sel00000/arduino-recycling-sorter/docs/code-review.ko.md

[English](code-review.md) | [한국어](code-review.ko.md)

# 코드 리뷰 — 기술 분석과 개선 제안

대회 당시 코드(`firmware/original/`)를 사후 분석한 문서입니다. `firmware/revised/`에
반영한 수정과, 코드에는 반영하지 않고 제안으로만 남긴 개선을 구분해 정리합니다.

## 스케치별 분석

### 1단계 — stage1_conveyor

**동작**: 초음파 2개로 거리를 측정해, 둘 다 기준(10cm/20cm) 이내로 물체가 감지되면
서보 0(벨트 구동), 하나라도 기준 밖이면 서보 90(연속회전 서보 기준 정지).

| # | 문제 | 처리 |
|---|---|---|
| 1 | `pulseIn(echo, HIGH)`에 타임아웃이 없어 에코 유실 시 기본 1초씩 통째로 대기. 센서가 2개 연쇄라 한 사이클이 2초 이상 멈출 수 있음 — "모터가 반응이 없다"고 느끼게 한 유력 원인 | revised: 30ms 타임아웃 + 실패 시 벨트 상태 유지 |
| 2 | 단발 측정이라 노이즈에 그대로 노출. 튄 값 한 번에 벨트가 들썩일 수 있음 | 제안: 3회 측정 중앙값 필터 |
| 3 | 연속회전 서보는 개체마다 정지점이 90에서 약간 어긋나 `write(90)`에도 벨트가 천천히 기는 경우가 있음 | 제안: `writeMicroseconds()`로 정지 펄스 폭 트림 |
| 4 | `int pos = 0;` 미사용 변수 | revised: 제거 |

### 2단계 — stage2_metal_sorter (초안)

**컴파일 오류 3건 (복합 원인 포함)** — 이 초안이 컴파일되지 않는 이유:

| 위치 | 코드 | 문제 |
|---|---|---|
| `setup()` | `pinMode(senor_pin, INPUT)` | `senor_pin` 미선언 (`#define senor 4`만 존재) |
| `setup()` | `tap_servo.attach(tap_servo_pin)` | `tap_servo`는 `#define tap_servo 5` 핀 매크로라 `.attach()` 호출 불가, `tap_servo_pin`도 미선언 |
| `loop()` | `digitalRead(sensor)` | `sensor` 미선언 (`senor`의 오타) |

같은 대상을 `senor`/`sensor`/`senor_pin`/`tap_servo`/`tap_servo_pin` 다섯 이름으로
부른 것이 원인입니다. revised에서는 핀을 `SENSOR_PIN`/`TAP_SERVO_PIN` 상수로
통일하고 서보를 `doorServo`/`tapServo` 객체로 분리했습니다.

**로직 측면**:
1. 측정 실패(에코 유실) 시 `duration=0 → distance=0 < 10`이라 **문이 열린 상태로
   고정**됩니다. 실패 모드가 "개방"인 것은 안전하지 않습니다. → revised: 타임아웃
   시 닫힘 유지
2. `if (val==0) {...} if (val==1) {...}`는 결과적으로 if/else와 같지만 의도가
   드러나지 않습니다. → revised: if/else로 명확화
3. 정전용량 근접센서는 출력 방식(NPN: 감지 시 LOW / PNP: 감지 시 HIGH)에 따라
   `val==0`의 의미가 뒤집히고, 24V 산업용 센서는 분압·레벨 변환이 필요합니다.
   사용한 모듈 기준의 배선 문서화가 함께 남았어야 했습니다.

### 3단계 — stage3_weight_sorter

**기록 상태**: 원문이 `loop()` 내부에서 끊겨 닫는 중괄호가 유실 → revised에서 복원.

참고: 3단계의 Serial 속도는 38400으로 1·2단계(115200)와 다릅니다. 보드별 Serial
모니터 설정 시 유의하세요.

| # | 문제 | 처리 |
|---|---|---|
| 1 | `scale.get_units(5)`는 HX711 기본 10SPS 기준 약 0.5초 블로킹. 무거운 물체 경로는 delay 5회와 합쳐 사이클이 약 5.6초 — 처리량의 직접적 상한 | 제안: 표본 수 축소 또는 80SPS 모드, 상태기계화 |
| 2 | 연쇄 `delay(1000)`은 서보 떨림을 가리기 위한 완충(작성자 기록). 근본 원인은 전원일 가능성이 높음 — MG996R급은 스톨 시 약 2.5A까지 끌어갈 수 있는데 우노 5V 레귤레이터로는 부족 | 제안: 외부 5~6V 전원 + 공통 GND + 470~1000µF 커패시터 |
| 3 | 계수 23600이 기준 분동 없이 설정되어 측정 단위가 불명확 (심사 Q7) | 제안: ① 빈 저울 `tare()` ② 기준 분동(예: 1.000kg) 올림 ③ `get_units()`가 1.000이 될 때까지 계수 조정 |
| 4 | 측정값 0.5 이하는 어떤 분기에도 안 걸려 **배출되지 않음**. 빈 페트병(수십 g)이 주 대상임을 감안하면 캘리브레이션 부재와 결합해 임계값 실효성이 검증되지 않음 | revised: 동작은 원본 유지, 주석으로 한계 명시 |

## 아키텍처 분석

우노 3대가 **통신 없이 독립 동작**합니다. 단계 간 동기화 수단이 없어 물체가 이전
단계 처리 중에 도착하면 충돌하며, 이를 각 단계의 긴 delay로 회피했습니다. 작동은
했지만 처리량과 신뢰성을 모두 희생한 트레이드오프입니다.

## 개선 로드맵 (우선순위순)

1. **delay 제거 — `millis()` 상태기계**: 각 스케치를 대기/측정/동작 상태로
   재구성하면 센서 폴링과 서보 동작이 겹칠 수 있어 반응성이 살아납니다.
2. **서보 전원 분리**: 위 3단계 문제 2 항목. 떨림 완충용 delay를 걷어낼 수 있는
   전제 조건입니다.
3. **보드 간 핸드셰이크**: 디지털 핀 1개를 busy 신호로 공유하기만 해도 단계 충돌이
   사라집니다. 더 나아가면 우노 3대를 Mega 1대로 통합하거나 I2C
   마스터-슬레이브로 묶을 수 있습니다.
4. **종이 분류 — 저비용 비전**: ESP32-CAM(1만 원대)에 TensorFlow Lite Micro 또는
   Edge Impulse로 학습한 경량 CNN을 올리면 분광 센서 없이 종이/페트 구분이
   가능합니다. 당시 "이미지 센서로 구분은 되는데 모터 연동이 안 됐다"는 문제는
   분류 보드와 구동 보드를 분리하고 시리얼로 분류 결과만 넘기는 구조로 풀 수
   있습니다.
5. **형상 정규화**: 투입 직후 압축 기구(산업 선별장의 압축 공정과 같은 원리)로
   형상 불균일 문제를 구조적으로 해결합니다.
