sel00000/arduino-recycling-sorter/docs/references.ko.md

[English](references.md) | [한국어](references.ko.md)

# 참고 자료 모음

프로젝트 진행 중 조사한 자료의 원본 목록입니다. 당시 기록 그대로 옮겼으며, 링크
생존 여부는 보장하지 않습니다.

## 센서

### 이미지 센서
- 아두이노에서 이미지 센서를 이용한 색상 트래킹 팬틸트 구현 (PinkWink) — https://pinkwink.kr/1150

### 주파수(사운드) 센서
- 아두이노와 사운드 센서를 이용한 주파수 변환(FFT) — https://youtube.com/shorts/Ipk9SH9DfGQ?feature=share

### 소리감지 센서
- 아두이노 코딩 #11 소리감지센서 (공대선배) — https://youtu.be/N6v8owKJz8M

### 초음파 센서
- 아두이노 다중 초음파센서 사용 (친절한삐삐씨) — https://m.blog.naver.com/vitro6273/221200479936

### 인체 감지 센서
- 인체 감지센서로 침입자 경보 부저 만들기 (ICbanQ) — https://blog.naver.com/icbanq/222735710606

### 무게 감지 센서 (로드셀)
- 로드셀 무게감지 센서로 무게 측정하기 (로보다인시스템) — https://m.blog.naver.com/eduino/221078931222

### 정전용량 센서
- [디스플레이 톺아보기] TSP(터치스크린패널)의 종류와 원리 (삼성디스플레이 뉴스룸) — https://news.samsungdisplay.com/12710
- 정전용량 터치센서의 원리 (tonykwun) — https://m.blog.naver.com/tonykwun/120175645334
- 정전용량 센서 원리 (안쓰리김원) — https://m.blog.naver.com/ysahn2k/220147025746
- 정전 용량식 레벨계 측정 원리 (Endress+Hauser) — https://youtu.be/n5pGu-LuJXY
- 정전용량 터치센서란? 센서 구현하기 (오픈랩) — https://m.blog.naver.com/roboholic84/221372823607
- 축전기 (위키백과) — https://ko.wikipedia.org/wiki/축전기
- 정전용량형 근접센서와 음료수 캔으로 악기 만들기 (러봇랩) — https://youtu.be/ZjHH4AZI19s

### 근접센서 일반
- 근접센서(Proximity sensors) (Technicus) — https://blog.naver.com/technicus81/222855634213
- 정전 용량형 센서란? — https://avtotachki.com/ko/chto-takoe-emkostnyj-datchik/
- Testing a capacitive proximity sensor (Curious Scientist) — https://youtu.be/F0YeykVvEQ4
- Inductive vs. capacitive sensors (SENSOR PARTNERS) — https://www.sensorpartners.com/en/knowledge-base/the-difference-between-inductive-and-capacitive-sensors/
- 아두이노 유도형 근접 센서 사용하기 (Miracle) — https://m.blog.naver.com/PostView.naver?isHttpsRedirect=true&blogId=123gtf&logNo=221233489523
- Tech Tip: Inductive vs Capacitive Sensors (Ramco) — https://www.ramcoi.com/blog/220/tech-tip-inductive-vs-capacitive-sensors
- 정전용량식 근접센서의 원리 — https://article2.tistory.com/824
- 그림으로 이해하는 근접 센서 기초 (픽써엘) — https://youtu.be/-b_IYP74aPs
- 근접센서 PNP DC24V 원리 이해 (볼트메이커) — https://youtu.be/jbym2VNjBPM
- CR18-8DP/8DN/8AO 정전용량 센서의 모든 것 (장갑낀 맥가이버) — https://youtu.be/0xn9uTSGfj0
- 근접 센서 (센서로세계로미래로) — https://m.blog.naver.com/iotsensor/221469817024
- 점유·이동·근접 센서 (KOCW 충남대 강의자료) — http://contents.kocw.or.kr/KOCW/document/2016/chungnam/chahanju/9.pdf
- 자동화센서 11.4~11.7 (bbkim전자) — https://youtu.be/zAZ2H2QhHYM
- 근접 센서 (위키백과) — https://ko.wikipedia.org/wiki/근접_센서

### 유도형 근접센서
- 금속탐지기 작동 원리 (미국아재 교실) — https://www.youtube.com/watch?v=RMSqL3DOiO8
- 유도형(고주파 발진형) 근접 센서 설명 (픽써엘) — https://youtu.be/V86LwSNa1FE
- 와전류가 발생하는 구조 (임장성) — https://m.blog.naver.com/jsrhim516/221143080811
- 와전류 손실(철손)이란? (젠지노 창고) — https://yyxx.tistory.com/127

## 구조
- 자판기가 작동하는 원리/내부구조 — https://youtu.be/j3927pdgcTM
- AI 기반 똑똑한 분리수거기 (AI타임스) — https://youtu.be/8M4FtqOvVXQ
- 못쓰는 가전제품 배출 및 처리 과정 — https://youtu.be/CokoCupngyI
- 재활용쓰레기 분류 AI 로봇 (ITmoda) — https://youtu.be/6yUbOwQcC6w
- 재활용 선별장 첨단화 — 플라스틱 재질까지 구별 (뉴스트리) — https://youtu.be/AD_57RcEiIY
- 재활용품 분류의 달인 (SBS 생활의 달인 559회) — https://youtu.be/iv1eyqVMFCM
- 분리수거 자동화 시스템 Recyclear 분류 영상 — https://youtu.be/IsF19la8Tis
- 과학상자에서 리미트 스위치를 이용한 모터 동작 범위 제어 — https://youtu.be/OOMzq58qVvc

### 컨베이어 구조
- 과학상자로 탱크 만들기 — https://youtu.be/Qe5bKgvNuy4
- How To Make Stickers (Mahalo my Dude) — https://youtu.be/GlecDUdZdkE
- Can Lego Play the Drums? (Brick Technology) — https://youtu.be/BlaY8kSTO28
- Conveyor belt toy (MrMickPosner) — https://youtu.be/2aVdOXWo-2Q
- Low Cost Automatic Multi-Purpose Mini Conveyor Belt (Miheer Maniar) — https://youtu.be/udW1BXp7NXw
- How to Make a Conveyor Belt System at Home (Easy HomeMade Projects) — https://youtu.be/o7VVmtX7SKs
- How to Build a Belt Conveyor (C-Trak Conveyors) — https://youtu.be/TET4ksZ1b2g

## 납땜·배선
- Arduino Bluetooth control car (L293D, HC-05) (Make DIY) — https://youtu.be/hI0UBvpuRTw

## 모터 (서보)
- 서보모터 구성, 서보드라이브가 분리된 이유 (공장자동화TV) — https://youtu.be/CQgS90fcY10
- Arduino Servo Motor MG996R (올마코딩) — https://youtu.be/EXRFdmsEK8k
- 왜 서보 모터가 움직이지 않을까? L293D 모터쉴드 (H_World) — https://youtu.be/VoQCWI9ojsc
- Servo Motors, how do they work? (The Engineering Mindset) — https://youtu.be/1WnGv-DPexc
- Servo Motor with Arduino MG996 (SDev Electronics) — https://youtu.be/WPQNad2gvEs
- 서보모터 떨림 현상 원인 — 전류 부족/GND 미연결 (for Makers) — https://youtu.be/qywuAx00x2k
- Servo motors vibration problem: solution with capacitor (Global Spy Hawk) — https://youtu.be/zasQSK4CulE
- 서보모터가 이상하게 작동해요 (아토플래닛) — https://m.blog.naver.com/dokkosam/221387857799
- Servo MG996R, Arduino Uno (Noc A) — https://youtu.be/wszxVSf1d1w

## 시간 처리 (delay/millis)
- 시간 관련 함수 설명, delay 없이 LED Blink (juahnpop) — https://juahnpop.tistory.com/75
- 시간 관련 함수 delay()/millis() — https://blog.naver.com/yuyyulee/220315430768

## 코딩 일반
- 코딩스탠다드: 함수 작성 (포프TV) — https://youtu.be/rbWSTXBYNFA
