sel00000/arduino-recycling-sorter/firmware/original/stage1_conveyor/stage1_conveyor.ino

/*
 * [Original record] Stage 1 conveyor belt — code as submitted to the Nano Day
 * competition, preserved unmodified (it compiles). The Korean comments below are
 * part of the historical record. Cleaned-up version: firmware/revised/stage1_conveyor/
 */
#include <Servo.h>
Servo servo1;

int echo1=3,trig1=2;
int echo2=5,trig2=4;

int pos=0;

void setup(){
  pinMode(trig1,OUTPUT);
  pinMode(echo1,INPUT);

  pinMode(trig2,OUTPUT);
  pinMode(echo2,INPUT);

  servo1.attach(9);
  Serial.begin(115200);
}

void loop(){
  delay(100);
  digitalWrite(trig1,HIGH);
  delayMicroseconds(10);
  digitalWrite(trig1,LOW);

  long distance1=pulseIn(echo1,HIGH)/58.2;

  Serial.print("distance1");
  Serial.print(distance1);
  Serial.println("cm");

  delay(100);
  digitalWrite(trig2,HIGH);
  delayMicroseconds(10);
  digitalWrite(trig2,LOW);

  long distance2=pulseIn(echo2,HIGH)/58.2;

  Serial.print("distance2");
  Serial.print(distance2);
  Serial.println("cm");

  if((distance1>10)||(distance2>20)){
    delay(50);
    servo1.write(90);
    delay(50);
      }else {
        servo1.write(0);
  }
}
