sel00000/arduino-recycling-sorter/(commit log)

2026-06-13 chore: 저장소 초기화 — .gitignore, 시제품 사진
2026-06-13 docs(firmware): 대회 당시 원본 스케치 3종 보존
    stage2는 초안(컴파일 불가), stage3은 기록 유실로 끝부분 잘림 — 상태를
    각 파일 상단 주석에 명시
2026-06-13 feat(firmware): 컴파일 가능하게 정리한 revised 스케치 3종
    동작 로직은 원본 그대로 유지. 컴파일 오류 수정, pulseIn 타임아웃,
    상수화, 주석 보강만 적용. arduino:avr:uno 대상 arduino-cli 컴파일 확인.
    [stage1_conveyor.ino, stage2_metal_sorter.ino, stage3_weight_sorter.ino]
2026-06-13 docs: README와 회고·코드리뷰·참고자료 문서 추가
2026-06-13 docs: switch to English-first docs, keep Korean as *.ko.md
2026-06-13 docs: correct Stage 2 sensor to capacitive (+ principle), add advisor Prof. Ki-Ho Han
    [stage2_metal_sorter.ino]
